bmgxyz/self-playing-piano/eda/key-driver/key-driver.cir

.title KiCad schematic
U6 __U6
U5 __U5
U3 __U3
U4 __U4
J1 __J1
U1 __U1
U2 __U2
J2 __J2
R1 G1 Net-_Q1-G_ 470
D1 __D1
J4 __J4
J3 __J3
D5 __D5
R5 G5 Net-_Q5-G_ 470
J5 __J5
Q5 __Q5
D2 __D2
Q1 __Q1
R2 G2 Net-_Q2-G_ 470
D3 __D3
Q3 __Q3
R3 G3 Net-_Q3-G_ 470
Q2 __Q2
R6 G6 Net-_Q6-G_ 470
Q6 __Q6
D6 __D6
D7 __D7
Q7 __Q7
R7 G7 Net-_Q7-G_ 470
Q4 __Q4
R4 G4 Net-_Q4-G_ 470
D4 __D4
D8 __D8
Q8 __Q8
R8 G8 Net-_Q8-G_ 470
.end
