bmgxyz/self-playing-piano/eda/coil-winder/coil-winder.kicad_pcb

## KiCad design eda/coil-winder/coil-winder.kicad_pcb (2025-12-26)

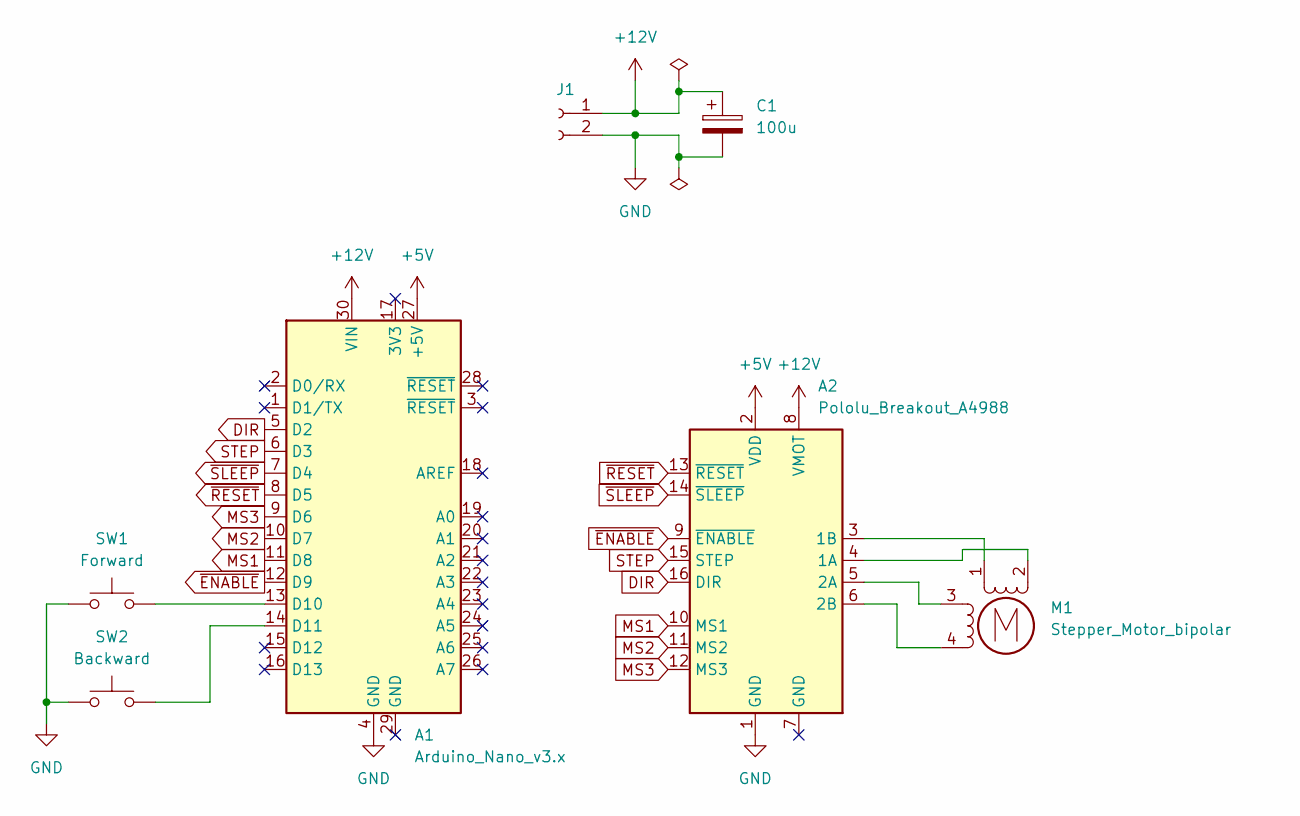
[picture p1: schematic coil-winder.kicad_sch, Coil Winder]

Parts:
A1: Arduino_Nano_v3.x; Arduino_Nano
A2: Pololu_Breakout_A4988; Pololu_Breakout-16_15.2x20.3mm
C1: 100u; CP_Radial_D5.0mm_P2.50mm
J1: Conn_01x02_Socket; JST_EH_B2B-EH-A_1x02_P2.50mm_Vertical
M1: Stepper_Motor_bipolar; JST_EH_B2B-EH-A_1x02_P2.50mm_Vertical_Double
SW1: Forward; SW_PUSH_6mm
SW2: Backward; SW_PUSH_6mm

Connections:
+5V: A1.27 (+5V), A2.2 (VDD)
+12V: A1.30 (VIN), A2.8 (VMOT), C1.1, J1.1
DIR: A1.5 (D2), A2.16 (DIR)
GND: A1.4 (GND), A2.1 (GND), C1.2, J1.2, SW1.1, SW2.1
MS1: A1.11 (D8), A2.10 (MS1)
MS2: A1.10 (D7), A2.11 (MS2)
MS3: A1.9 (D6), A2.12 (MS3)
unnamed: A1.13 (D10), SW1.2
unnamed: A1.14 (D11), SW2.2
unnamed: A2.4 (1A), M1.2 (-)
unnamed: A2.3 (1B), M1.1
unnamed: A2.5 (2A), M1.3
unnamed: A2.6 (2B), M1.4
STEP: A1.6 (D3), A2.15 (STEP)
~ENABLE: A1.12 (D9), A2.9 (~ENABLE)
~RESET: A1.8 (D5), A2.13 (~RESET)
~SLEEP: A1.7 (D4), A2.14 (~SLEEP)

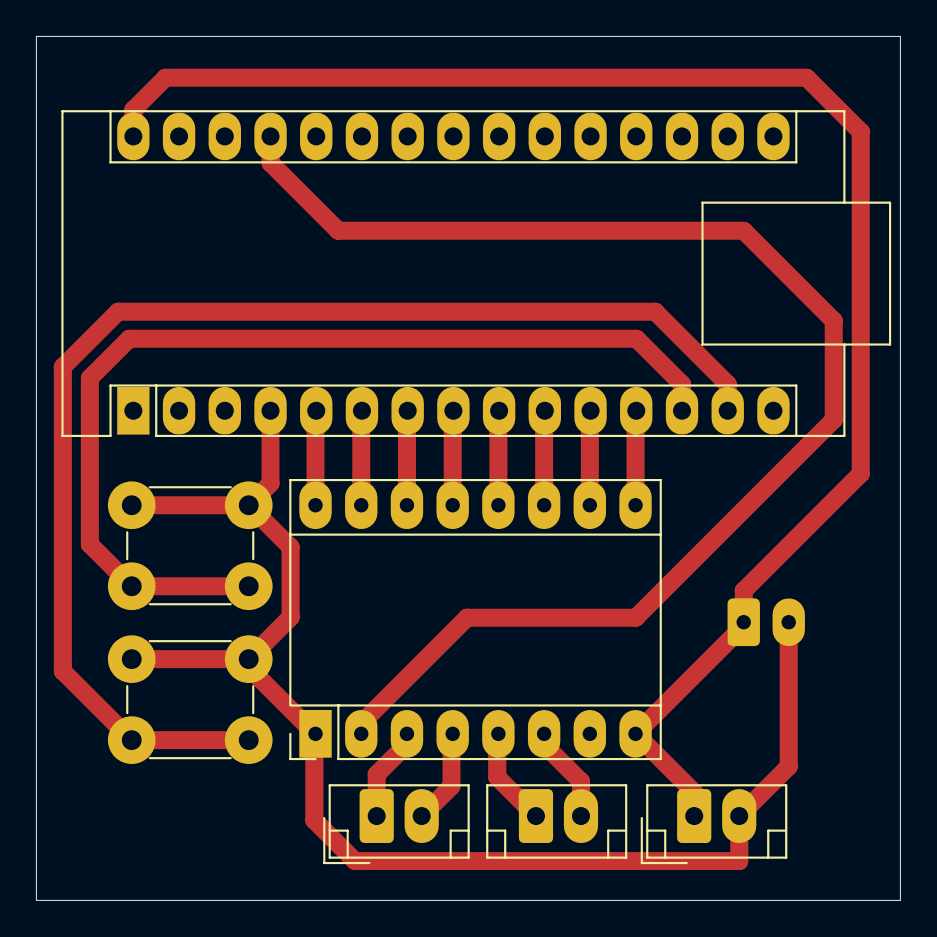
[picture p2: board coil-winder.kicad_pcb from above]

Board: 2 copper layers, 48.0 x 48.0 mm, 7 parts (0 on the bottom side), 17 nets.
