bmgxyz/self-playing-piano/eda/key-driver/key-driver.kicad_pcb

## KiCad design eda/key-driver/key-driver.kicad_pcb (2025-11-17)

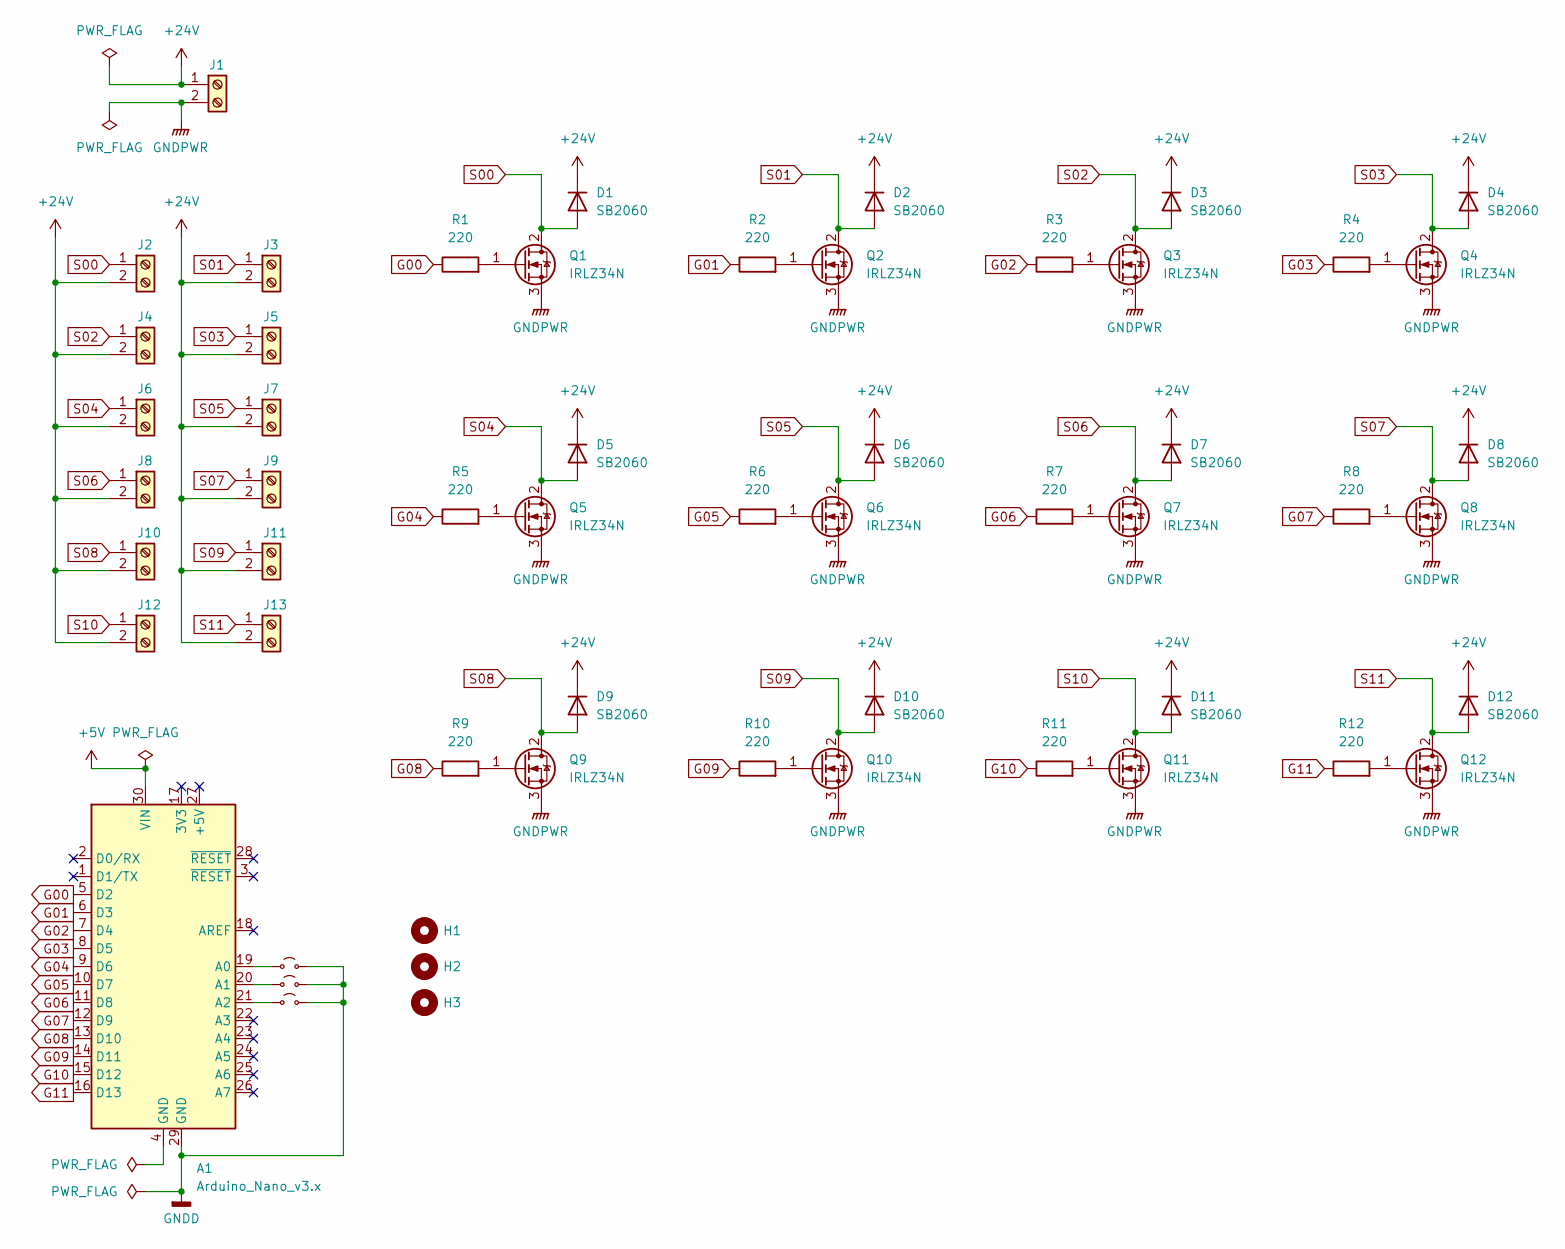
[picture p3: schematic key-driver.kicad_sch, Piano Key Driver]

Parts:
A1: Arduino_Nano_v3.x; Arduino_Nano
D1, D2, D3, D4, D5, D6, D7, D8, D9, D10, D11, D12: SB2060; D_DO-201AE_P5.08mm_Vertical_KathodeUp
H1, H2, H3: MountingHole; MountingHole_3.2mm_M3
J1, J2, J3, J4, J5, J6, J7, J8, J9, J10, J11, J12, J13: Screw_Terminal_01x02; JST_EH_B2B-EH-A_1x02_P2.50mm_Vertical
JP1, JP2, JP3: Jumper_2_Small_Open; PinHeader_1x02_P2.54mm_Vertical
Q1, Q2, Q3, Q4, Q5, Q6, Q7, Q8, Q9, Q10, Q11, Q12: IRLZ34N; TO-220-3_Vertical
R1, R2, R3, R4, R5, R6, R7, R8, R9, R10, R11, R12: 220; R_Axial_DIN0204_L3.6mm_D1.6mm_P7.62mm_Horizontal

Connections:
+5V: A1.30 (VIN)
+24V: D1.1 (K), D2.1 (K), D3.1 (K), D4.1 (K), D5.1 (K), D6.1 (K), D7.1 (K), D8.1 (K), D9.1 (K), D10.1 (K), D11.1 (K), D12.1 (K), J1.1, J2.2, J3.2, J4.2, J5.2, J6.2, J7.2, J8.2, J9.2, J10.2, J11.2, J12.2, J13.2
G00: A1.5 (D2), R1.1
G01: A1.6 (D3), R2.1
G02: A1.7 (D4), R3.1
G03: A1.8 (D5), R4.1
G04: A1.9 (D6), R5.1
G05: A1.10 (D7), R6.1
G06: A1.11 (D8), R7.1
G07: A1.12 (D9), R8.1
G08: A1.13 (D10), R9.1
G09: A1.14 (D11), R10.1
G10: A1.15 (D12), R11.1
G11: A1.16 (D13), R12.1
GNDD: A1.29 (GND), JP1.2 (B), JP2.2 (B), JP3.2 (B)
GNDPWR: J1.2, Q1.3 (S), Q2.3 (S), Q3.3 (S), Q4.3 (S), Q5.3 (S), Q6.3 (S), Q7.3 (S), Q8.3 (S), Q9.3 (S), Q10.3 (S), Q11.3 (S), Q12.3 (S)
unnamed: A1.19 (A0), JP1.1 (A)
unnamed: A1.20 (A1), JP2.1 (A)
unnamed: A1.21 (A2), JP3.1 (A)
unnamed: Q1.1 (G), R1.2
unnamed: Q2.1 (G), R2.2
unnamed: Q3.1 (G), R3.2
unnamed: Q4.1 (G), R4.2
unnamed: Q5.1 (G), R5.2
unnamed: Q6.1 (G), R6.2
unnamed: Q7.1 (G), R7.2
unnamed: Q8.1 (G), R8.2
unnamed: Q9.1 (G), R9.2
unnamed: Q10.1 (G), R10.2
unnamed: Q11.1 (G), R11.2
unnamed: Q12.1 (G), R12.2
S00: D1.2 (A), J2.1, Q1.2 (D)
S01: D2.2 (A), J3.1, Q2.2 (D)
S02: D3.2 (A), J4.1, Q3.2 (D)
S03: D4.2 (A), J5.1, Q4.2 (D)
S04: D5.2 (A), J6.1, Q5.2 (D)
S05: D6.2 (A), J7.1, Q6.2 (D)
S06: D7.2 (A), J8.1, Q7.2 (D)
S07: D8.2 (A), J9.1, Q8.2 (D)
S08: D9.2 (A), J10.1, Q9.2 (D)
S09: D10.2 (A), J11.1, Q10.2 (D)
S10: D11.2 (A), J12.1, Q11.2 (D)
S11: D12.2 (A), J13.1, Q12.2 (D)

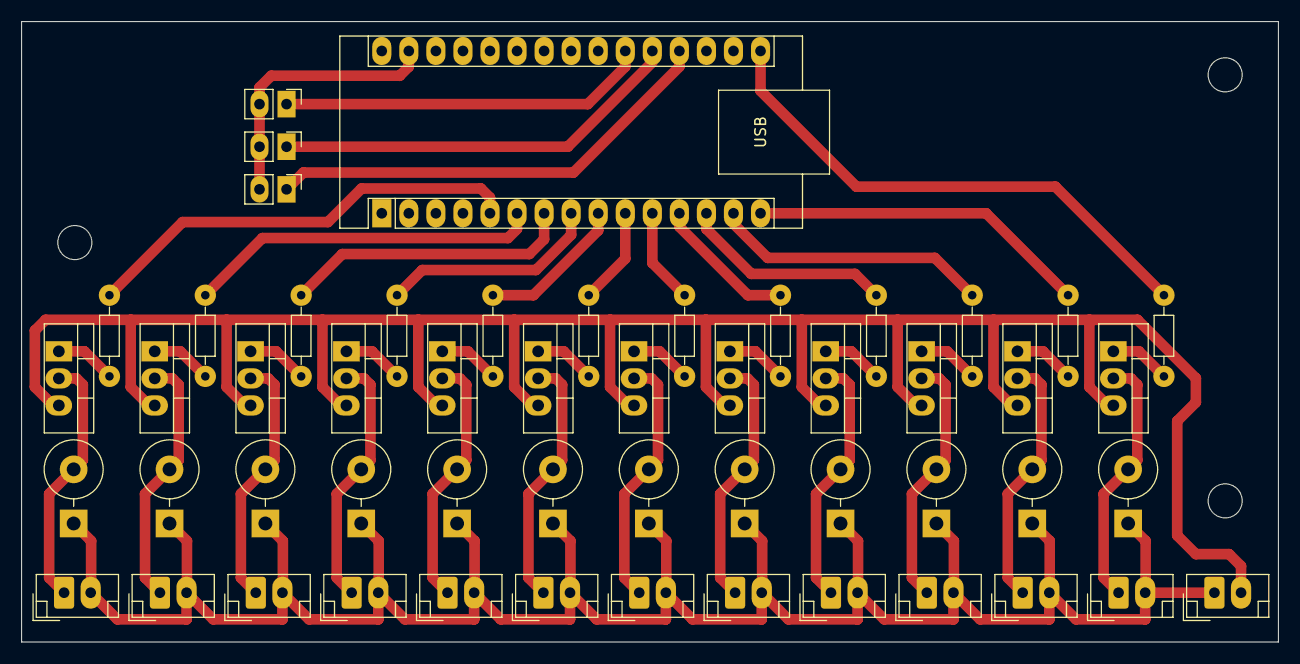
[picture p4: board key-driver.kicad_pcb from above]

Board: 2 copper layers, 118.0 x 58.2 mm, 56 parts (0 on the bottom side), 42 nets.
