bmgxyz/self-playing-piano/eda/midi-driver/midi-driver.kicad_pcb

## KiCad design eda/midi-driver/midi-driver.kicad_pcb (2025-08-15)

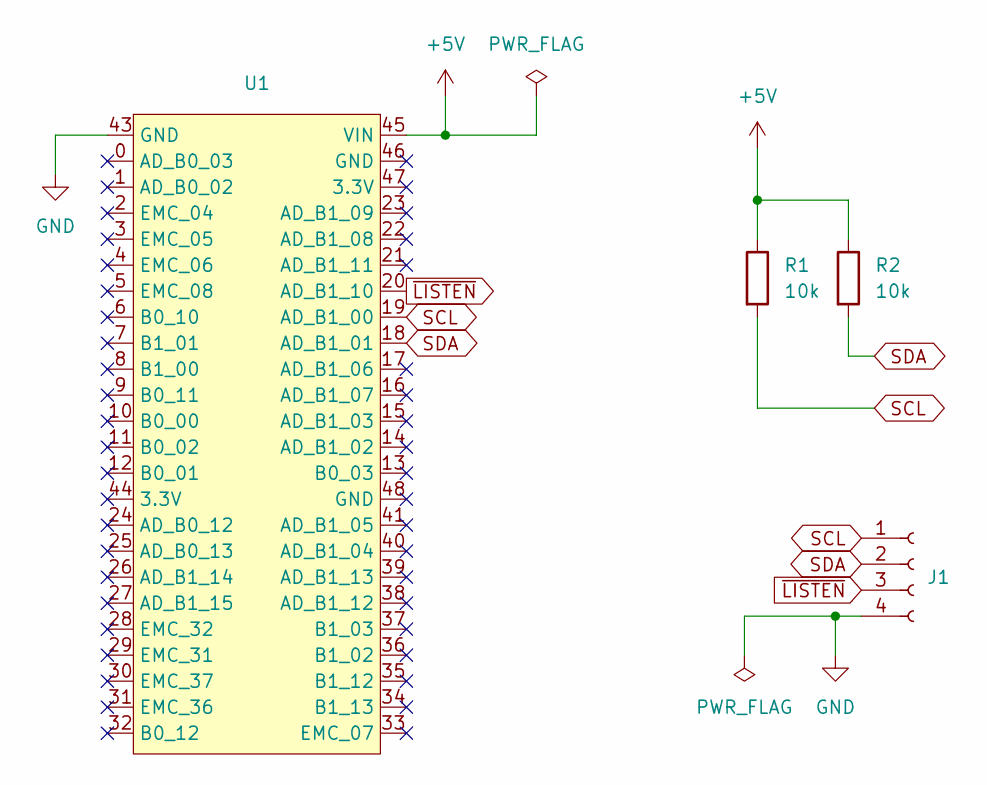
[picture p5: schematic midi-driver.kicad_sch, Piano MIDI Driver]

Parts:
J1: Conn_01x04_Socket; PinSocket_1x04_P2.54mm_Vertical
R1, R2: 10k; R_Axial_DIN0204_L3.6mm_D1.6mm_P7.62mm_Horizontal
U1: Teensy41

Connections:
+5V: R1.1, R2.1, U1.45 (VIN)
GND: J1.4, U1.43 (GND)
SCL: J1.1, R1.2, U1.19 (AD_B1_00)
SDA: J1.2, R2.2, U1.18 (AD_B1_01)
~LISTEN: J1.3, U1.20 (AD_B1_10)

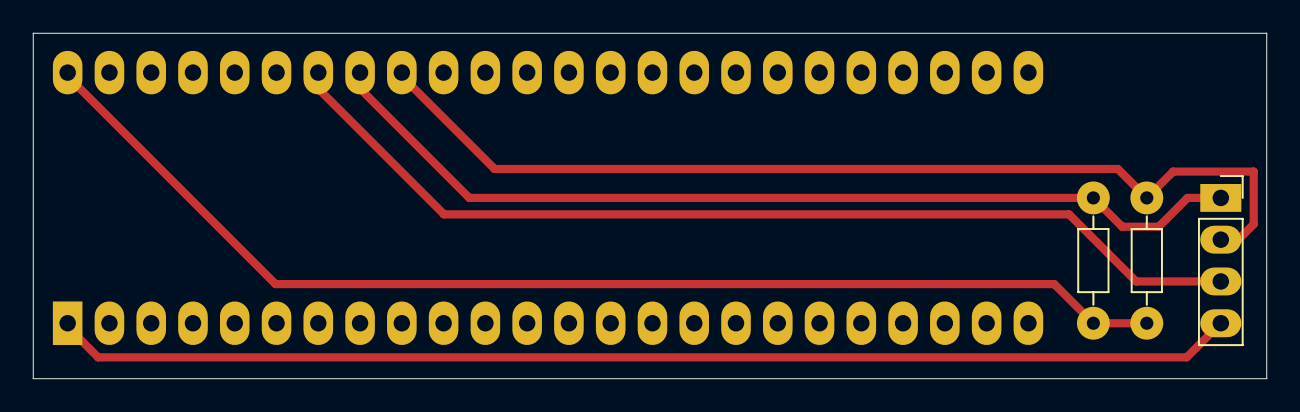
[picture p6: board midi-driver.kicad_pcb from above]

Board: 2 copper layers, 75.0 x 21.0 mm, 4 parts (0 on the bottom side), 5 nets.
