bmgxyz/self-playing-piano/(commit log)

2024-04-02 Add solenoid actuator model
2024-08-09 Tweak solenoid model and move to subdir
2024-08-10 Refactor CAD models
2024-09-01 Make various CAD improvements and tweaks
2024-09-01 Add schematic and PCB for eleven key module
    [eleven-key-module.kicad_pcb, eleven-key-module.kicad_sch]
2024-09-01 Add PWM scaling, add transition diagram, improve FSM, add Makefile
2024-09-02 Fix some controller bugs after testing
    [main.rs]
2024-09-04 Decrease FPGA clock frequency to give ~20 kHz PWM output
2024-09-06 Make initial changes to switch to AVR PWM
2024-09-06 Add code for AVR PWM
2024-09-06 Remove code for FPGA PWM
2024-10-15 Switch schematic to Atmega328P
    [eleven-key-module.kicad_pcb, eleven-key-module.kicad_sch]
2024-10-15 Add serial logging, update PWM values, some tweaks
2024-10-15 Add script to estimate solenoid wire length
2025-04-30 Switch to I2C on subcontroller
2025-05-01 Switch to I2C on main controller
2025-05-01 Bump deps, continue I2C switch, and minor reformatting
2025-05-01 Replace global logger with version that's passed by reference as needed
    [main.rs]
2025-05-03 Fix new logging system
    [main.rs]
2025-05-06 Fix I2C and PWM on subcontroller
2025-05-06 Fix lingering controller communication issues and test end-to-end (MIDI to PWM)
    [main.rs, pwm.rs]
2025-05-12 Fix I2C for standalone Atmega328P
2025-05-13 Fix logic bug in subcontroller address
    [pwm.rs]
2025-05-16 Update KiCad version and convert schematic to I2C
    [eleven-key-module.kicad_sch]
2025-05-16 Further update schematic and create PCB
    [eleven-key-module.kicad_pcb, eleven-key-module.kicad_sch]
2025-05-31 Refactor key platform and generally improve CAD code
2025-05-31 Remove steel support and solenoid winder CAD models
2025-06-15 Add control signal to stop PWM during I2C transactions
2025-06-17 Fix checksum on main controller
    [pwm.rs]
2025-07-04 Switch main controller to enhanced shift register approach
2025-07-04 Remove AVR PWM
2025-07-06 Add hold PWM signal generation
2025-07-17 Migrate to RTIC and handle USB with interrupt
2025-08-09 Reorg EDA code, modify key driver to use Arduino Nano
    [key-driver.kicad_pcb, key-driver.kicad_sch]
2025-08-09 Collect all firmware into one dir, add key driver code based on Arduino Nano and common library code
2025-08-09 Remove old eleven-key-module KiCad project
    [eleven-key-module.kicad_pcb, eleven-key-module.kicad_sch]
2025-08-09 Move .gitignore for EDA up one level and add blank KiCad project for MIDI driver
    [midi-driver.kicad_pcb, midi-driver.kicad_sch]
2025-08-15 Improve key driver circuit (r3)
    [key-driver.kicad_pcb, key-driver.kicad_sch]
2025-08-15 Add MIDI driver circuit (r1)
    [midi-driver.kicad_pcb, midi-driver.kicad_sch]
2025-08-15 Remove old MIDI driver firmware, which I added by mistake
    [index.rs, main.rs, midi.rs, pwm.rs]
2025-08-15 Remove key-driver.hex, which I added by mistake
2025-08-16 Fix some firmware bugs
    [index.rs, main.rs, pwm.rs]
2025-08-21 Modify key driver code to use a schedule and read it from serial
2025-08-21 Add host-side bothoven binary to control key drivers
2025-08-21 Remove MIDI driver
2025-08-25 Make the default PWM schedule set all key pins low, and other improvements
2025-08-25 Fix key driver pin assignment error from testing
    [main.rs]
2025-10-18 Add end support CAD model
2025-10-22 Add end support spacer, reorg a bit
2025-10-22 Switch to uv
2025-10-22 Migrate key platform to new wood rail approach and remove old code for standalone platform
2025-11-17 Modify key support CAD code to use new key arrangement
2025-11-17 Modify key driver schematic and PCB to use new key arrangement, JST connectors, and wider traces
    [key-driver.kicad_pcb, key-driver.kicad_sch]
2025-11-17 Modify key driver firmware to use new key arrangement
2025-11-20 Improve performance of key driver schedule code
2025-12-26 Add coil winder
    [coil-winder.kicad_pcb, coil-winder.kicad_sch]
2026-02-15 Modify plunger design to load from above instead of below the solenoids
2026-02-23 Make host code handle multiple key drivers and bump some deps
2026-03-26 Interpret note on MIDI messages with zero velocity as note off
